bml3mk5/L3mk5ExRam/L3mk5ExRam.brd

## EAGLE design L3mk5ExRam.brd (2023-03-06)

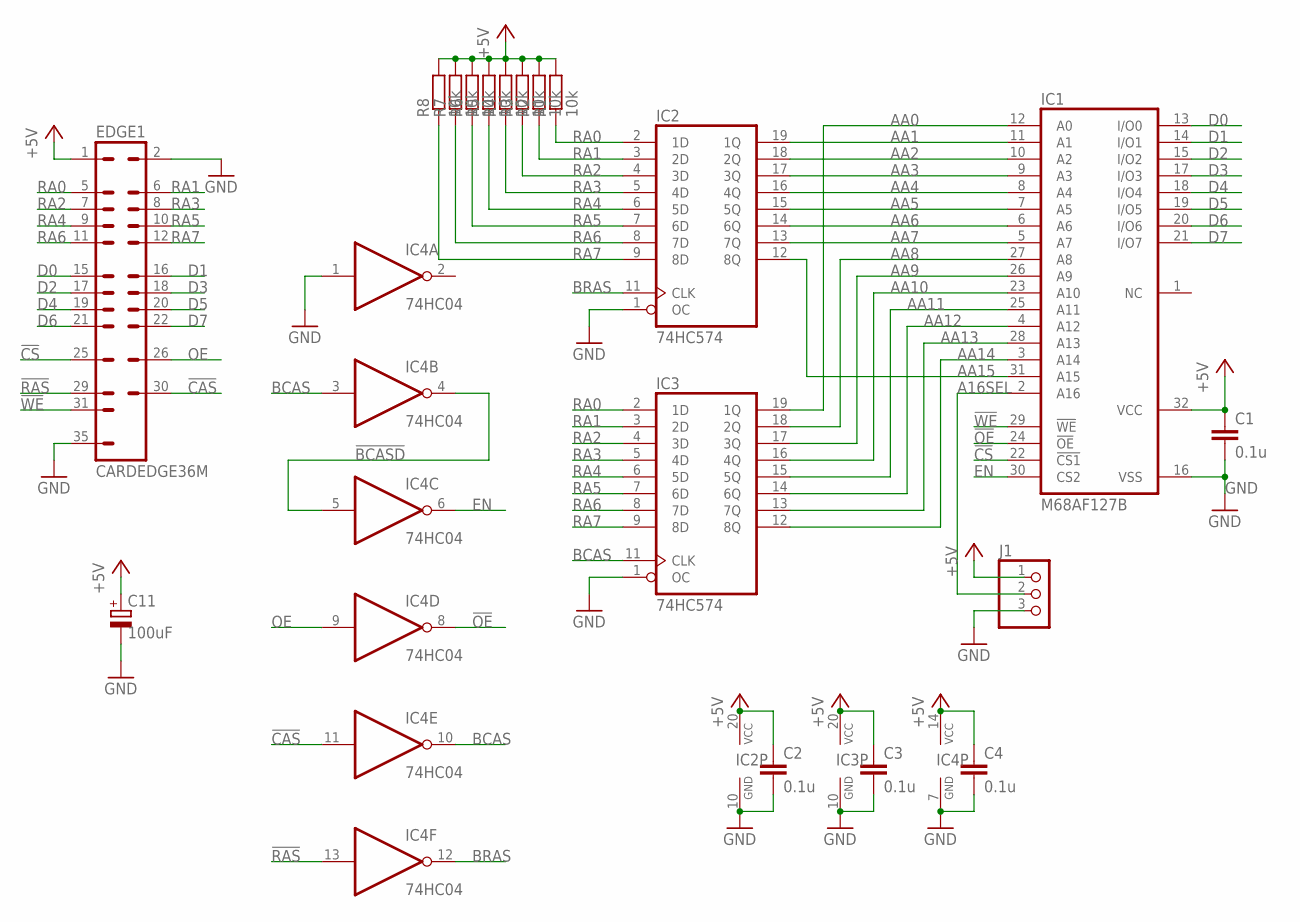
[picture p3: schematic L3mk5ExRam.sch]

Parts:
C1, C2, C3, C4: 0.1u; C025-024X044
C11: 100uF; E2-5
EDGE1: CARDEDGE36M; PM
IC1: M68AF127B; SOJ32-400
IC2, IC3: 74HC574; DIL20
IC4: 74HC04; DIL14
J1: PINHD-1X3; 1X03
R1, R2, R3, R4, R5, R6, R7, R8: 10k; 0204V

Connections:
!BCASD: IC4.4 (O), IC4.5 (I)
!CAS: EDGE1.30, IC4.11 (I)
!CS: EDGE1.25, IC1.22 (!CS1)
!OE: IC1.24 (!OE), IC4.8 (O)
!RAS: EDGE1.29, IC4.13 (I)
!WE: EDGE1.31, IC1.29 (!WE)
+5V: C1.1, C2.1, C3.1, C4.1, C11.+, EDGE1.1, IC1.32 (VCC), IC2.20 (VCC), IC3.20 (VCC), IC4.14 (VCC), J1.1, R1.2, R2.2, R3.2, R4.2, R5.2, R6.2, R7.2, R8.2
A16SEL: IC1.2 (A16), J1.2
AA0: IC1.12 (A0), IC3.19 (1Q)
AA1: IC1.11 (A1), IC2.19 (1Q)
AA2: IC1.10 (A2), IC2.18 (2Q)
AA3: IC1.9 (A3), IC2.17 (3Q)
AA4: IC1.8 (A4), IC2.16 (4Q)
AA5: IC1.7 (A5), IC2.15 (5Q)
AA6: IC1.6 (A6), IC2.14 (6Q)
AA7: IC1.5 (A7), IC2.13 (7Q)
AA8: IC1.27 (A8), IC3.18 (2Q)
AA9: IC1.26 (A9), IC3.17 (3Q)
AA10: IC1.23 (A10), IC3.16 (4Q)
AA11: IC1.25 (A11), IC3.15 (5Q)
AA12: IC1.4 (A12), IC3.14 (6Q)
AA13: IC1.28 (A13), IC3.13 (7Q)
AA14: IC1.3 (A14), IC3.12 (8Q)
AA15: IC1.31 (A15), IC2.12 (8Q)
BCAS: IC3.11 (CLK), IC4.3 (I), IC4.10 (O)
BRAS: IC2.11 (CLK), IC4.12 (O)
D0: EDGE1.15, IC1.13 (I/O0)
D1: EDGE1.16, IC1.14 (I/O1)
D2: EDGE1.17, IC1.15 (I/O2)
D3: EDGE1.18, IC1.17 (I/O3)
D4: EDGE1.19, IC1.18 (I/O4)
D5: EDGE1.20, IC1.19 (I/O5)
D6: EDGE1.21, IC1.20 (I/O6)
D7: EDGE1.22, IC1.21 (I/O7)
EN: IC1.30 (CS2), IC4.6 (O)
GND: C1.2, C2.2, C3.2, C4.2, C11.-, EDGE1.2, EDGE1.35, IC1.16 (VSS), IC2.1 (OC), IC2.10 (GND), IC3.1 (OC), IC3.10 (GND), IC4.1 (I), IC4.7 (GND), J1.3
OE: EDGE1.26, IC4.9 (I)
RA0: EDGE1.5, IC2.2 (1D), IC3.2 (1D), R1.1
RA1: EDGE1.6, IC2.3 (2D), IC3.3 (2D), R2.1
RA2: EDGE1.7, IC2.4 (3D), IC3.4 (3D), R3.1
RA3: EDGE1.8, IC2.5 (4D), IC3.5 (4D), R4.1
RA4: EDGE1.9, IC2.6 (5D), IC3.6 (5D), R5.1
RA5: EDGE1.10, IC2.7 (6D), IC3.7 (6D), R6.1
RA6: EDGE1.11, IC2.8 (7D), IC3.8 (7D), R7.1
RA7: EDGE1.12, IC2.9 (8D), IC3.9 (8D), R8.1

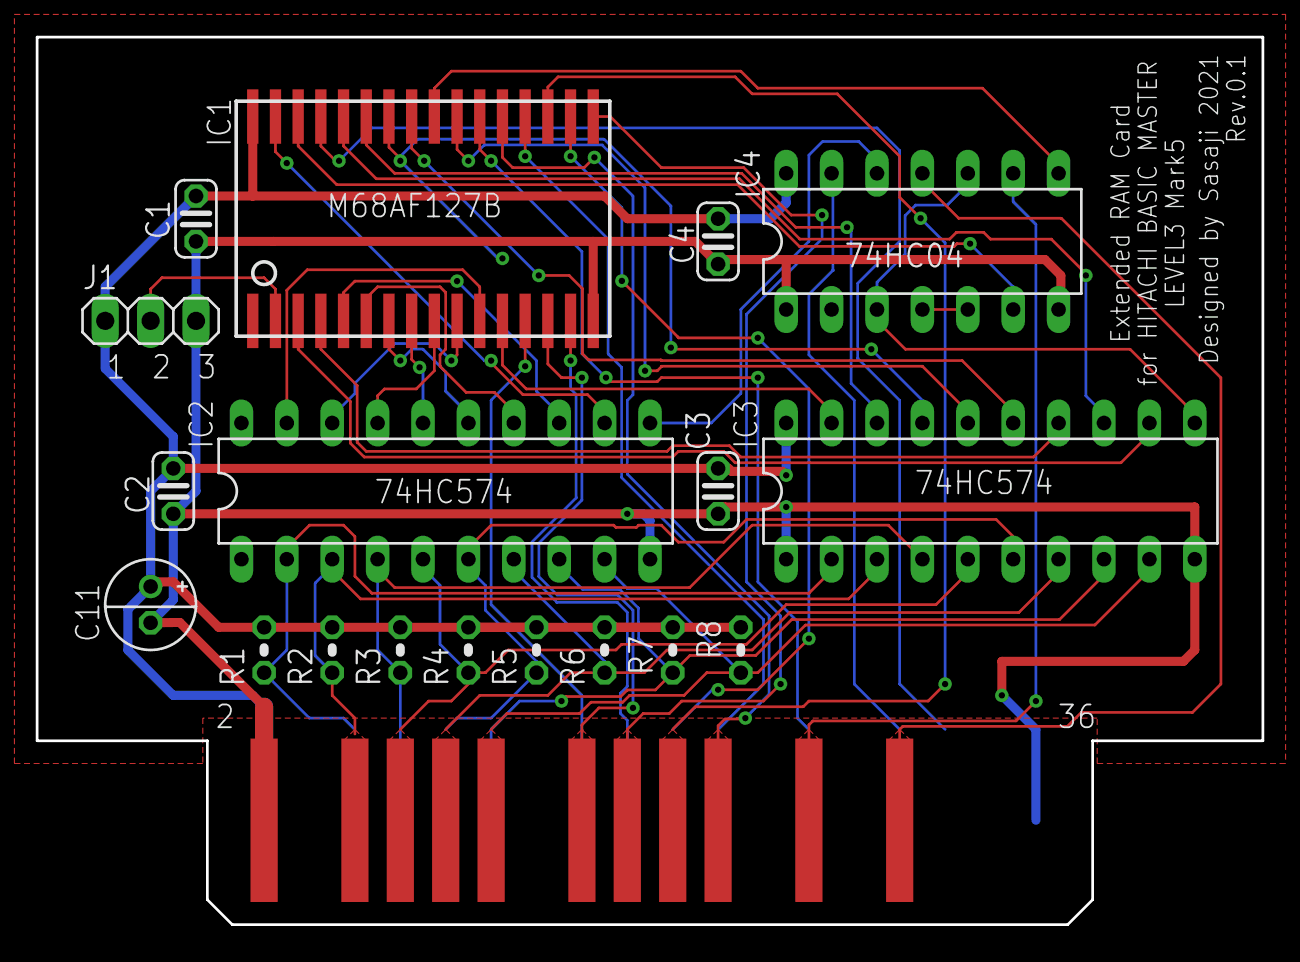
[picture p4: board L3mk5ExRam.brd from above]

Board: 2 copper layers, 68.6 x 49.7 mm, 19 parts (0 on the bottom side), 45 nets.
